CascoLogix/MSP430AFE253_Demo_Board/Hardware/MSP430AFE253_Pinout.xlsx

MSP430AFE253
Pin# | Pin Name | Alt Pin Name
1 | A0.0+
2 | A0.0-
3 | A1.0+
4 | A1.0-
5 | AVCC
6 | AVSS
7 | VREF
8 | A2.0+
9 | A2.0-
10 | TEST | SBWTCK
11 | ~RST | NMI/SBWTDIO
12 | P1.0 | SVSIN/TACLK/SMCLK/TA2
13 | DVSS
14 | P2.6 | XT2IN
15 | P2.7 | XT2OUT
16 | DVCC
17 | P1.1 | TA1/SDCLK
18 | P1.2 | TA0/SD0DO
19 | P1.3 | UTXD0/SD1DO
20 | P1.4 | URXD0/SD2DO
21 | P1.5 | SIMO0/SVSOUT/TMS
22 | P1.6 | SOMI0/TA2/TCK
23 | P1.7 | UCLK0/TA1/TDO/TDI
24 | P2.0 | STE0/TA0/TDI/TCLK
