CascoLogix/MSP430AFE253_Demo_Board/Rendered_Pics/MSP430AFE253_Demo_Board7.png

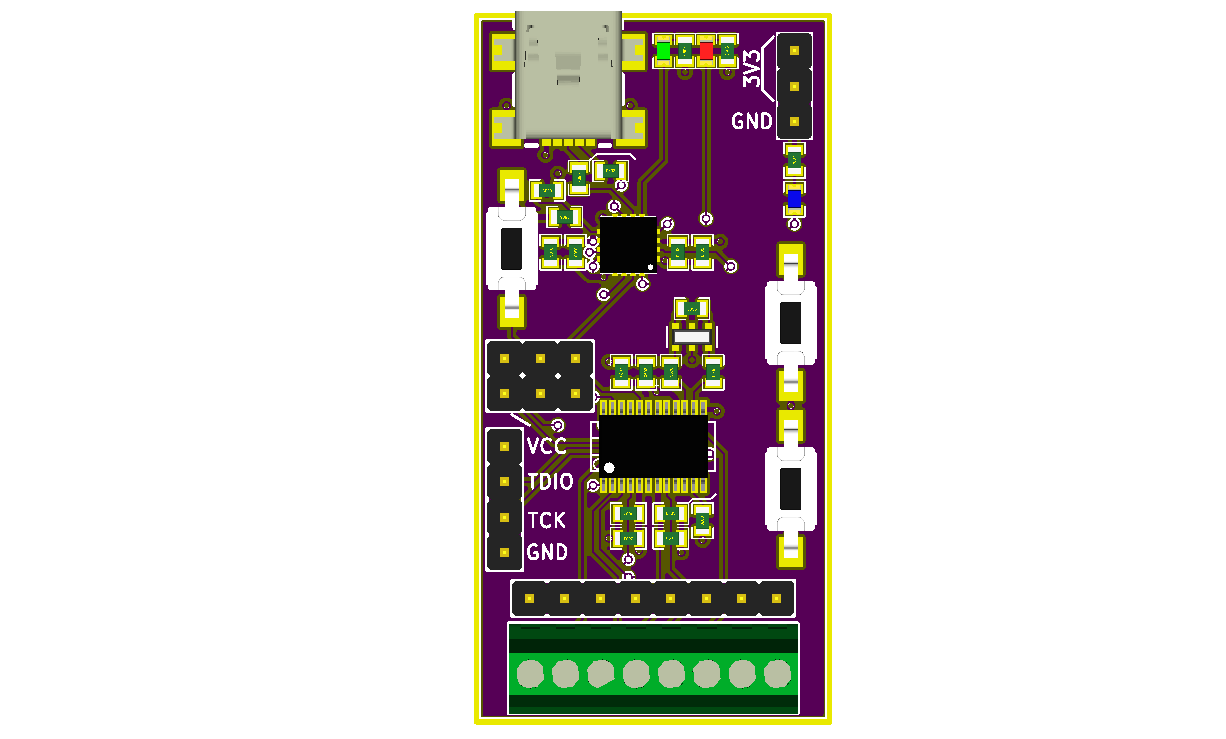
Rendered_Pics/MSP430AFE253_Demo_Board7.png
