CascoLogix/MSP430AFE253_Demo_Board/Rendered_Pics/MSP430AFE253_Demo_Board11.png

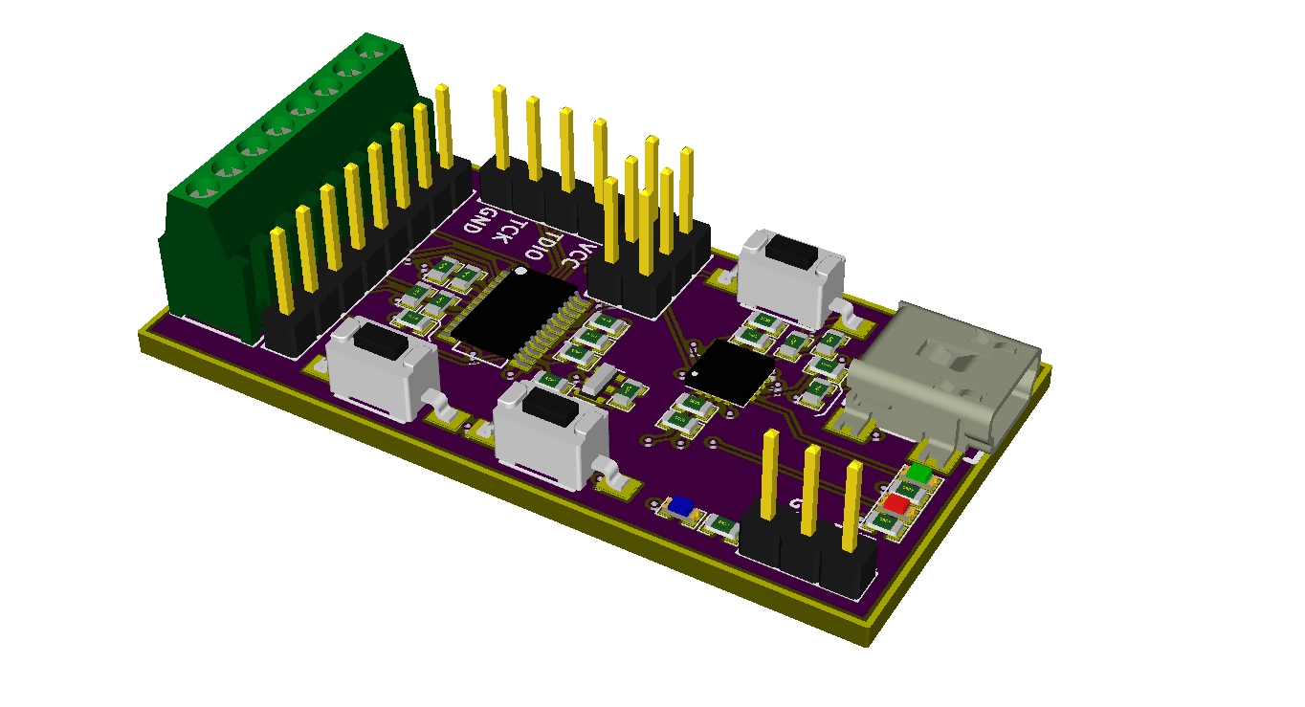
Rendered_Pics/MSP430AFE253_Demo_Board11.png
