CascoLogix/MSP430AFE253_Demo_Board/Rendered_Pics/MSP430AFE253_Demo_Board14.png

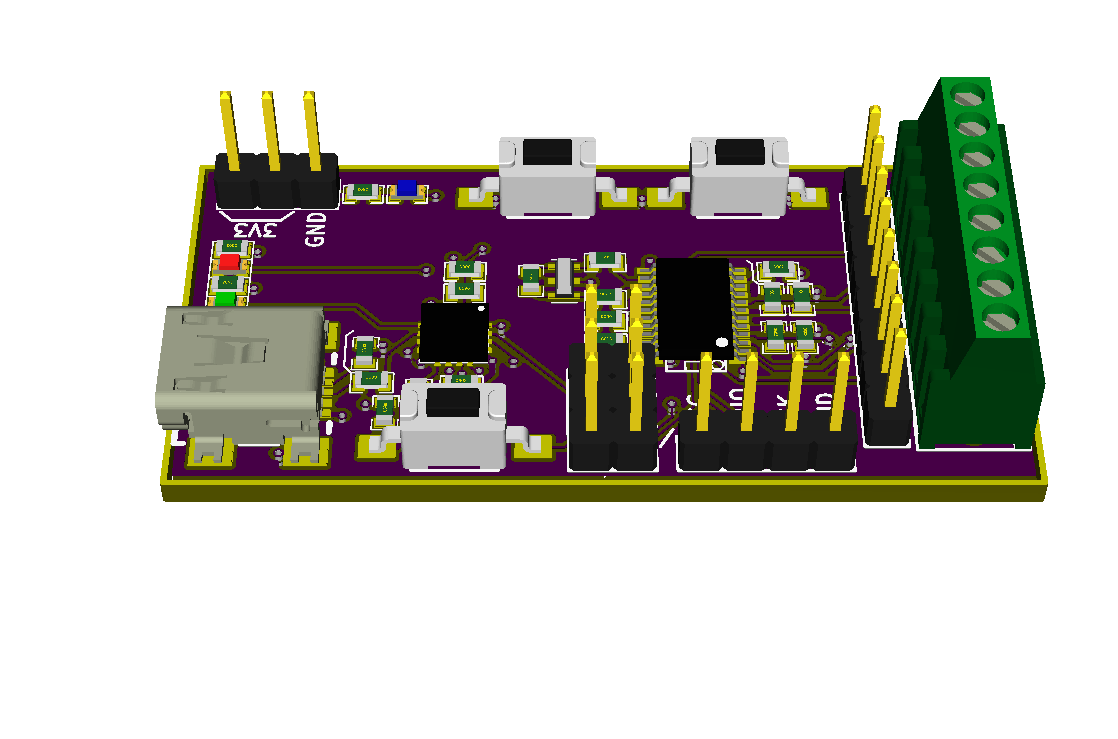
Rendered_Pics/MSP430AFE253_Demo_Board14.png
