CascoLogix/MSP430AFE253_Demo_Board/Rendered_Pics/MSP430AFE253_Demo_Board16.png

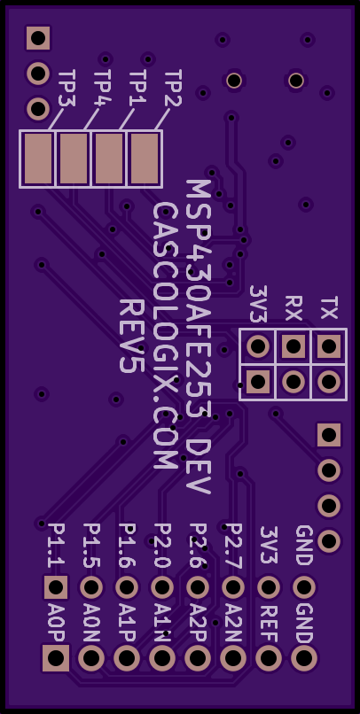
Rendered_Pics/MSP430AFE253_Demo_Board16.png
