CascoLogix/MSP430AFE253_Demo_Board/(list of files, cad)

Other CAD files:
Hardware/KiCAD_Project_Files/MSP430AFE253_Demo_Board.dxf
