CascoLogix/MSP430AFE253_Demo_Board/Hardware/Drawing/MSP430AFE253_Dev_Board_Schematic.pdf

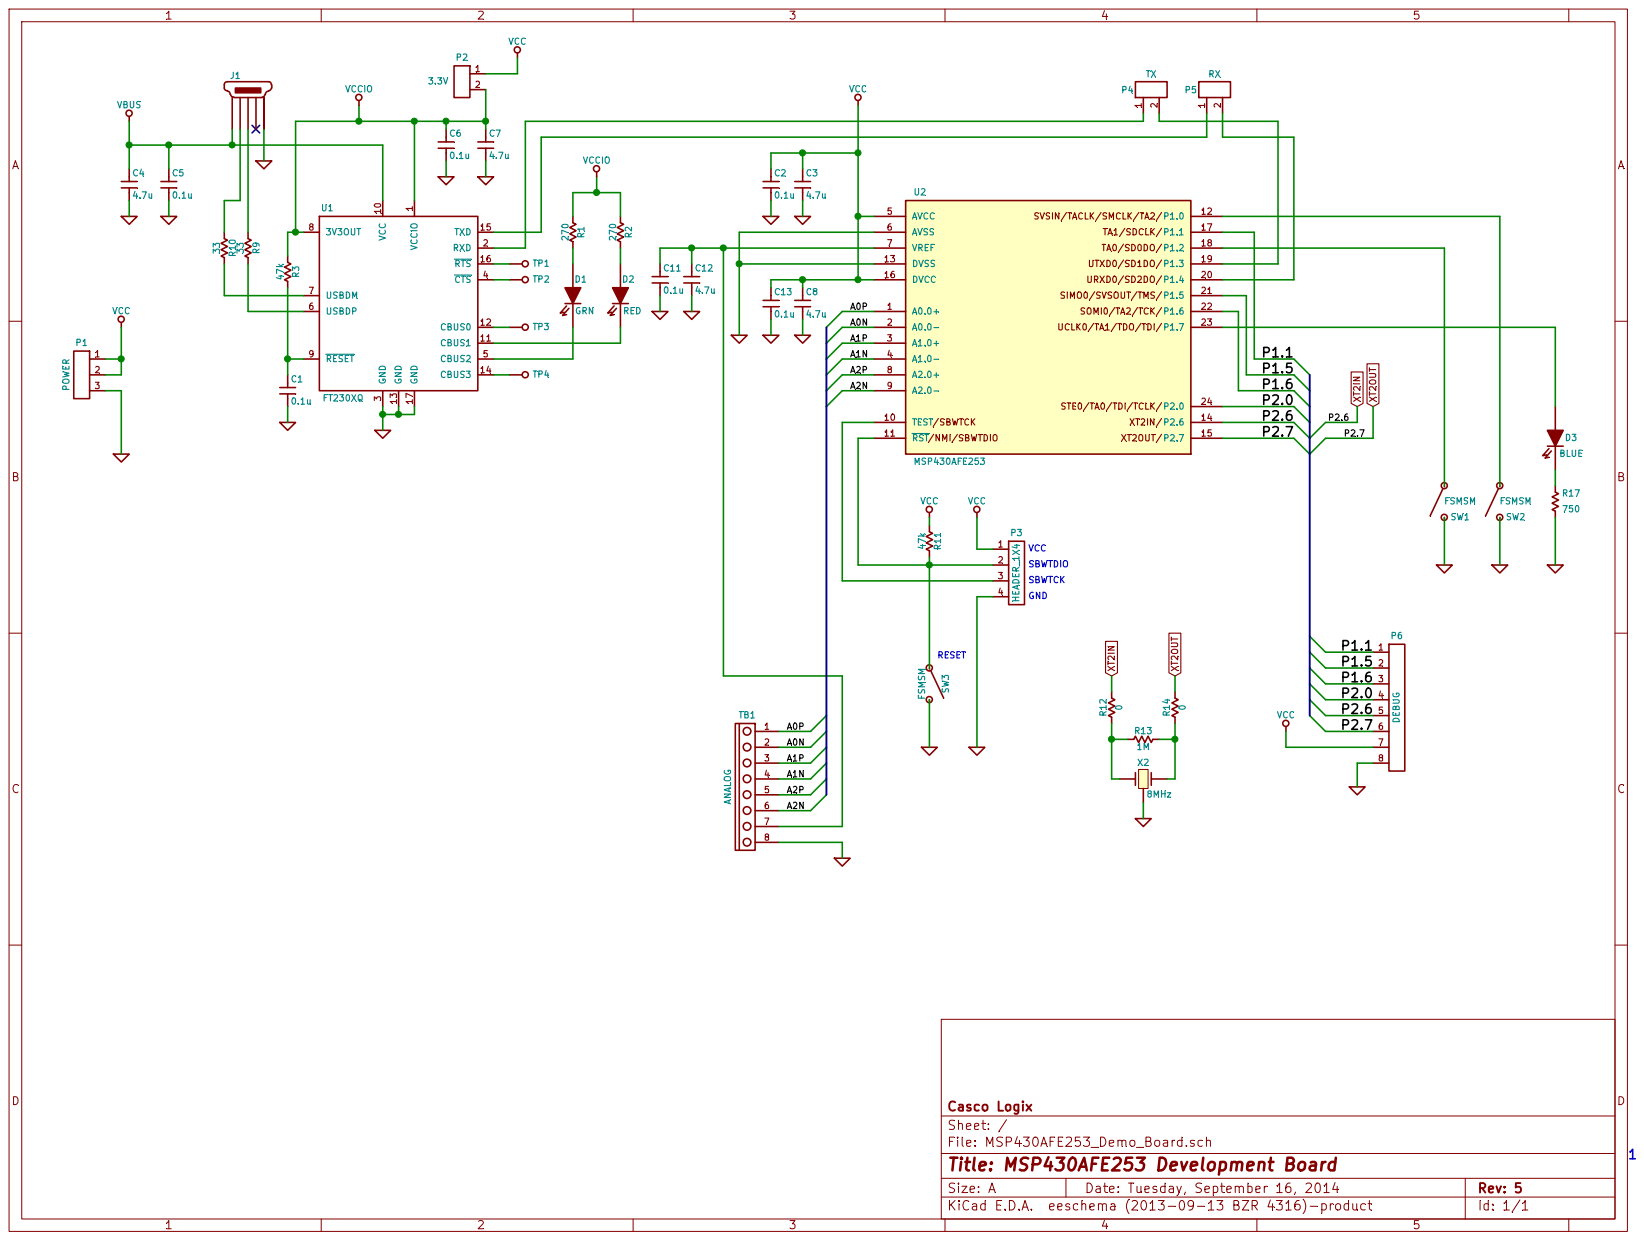
[picture p34: page 1]
