CascoLogix/MSP430AFE253_Demo_Board/Hardware/KiCAD_Project_Files/MSP430AFE253_Demo_Board.kicad_pcb

## KiCad design Hardware/KiCAD_Project_Files/MSP430AFE253_Demo_Board.kicad_pcb (2014-09-22)

Schematic: MSP430AFE253_Demo_Board.sch, MSP430AFE253 Development Board

Parts:
C1, C2, C5, C6, C11, C13: 0.1u
C3, C4, C7, C8, C12: 4.7u
D1: GRN
D2: RED
D3: BLUE
J1: USB_MINI_B
P1: POWER
P2: 3.3V
P3: HEADER_1X4
P4: TX
P5: RX
P6: DEBUG
R1, R2: 270
R3, R11: 47k
R9, R10: 33
R12, R14: 0
R13: 1M
R17: 750
SW1, SW2, SW3: FSMSM
TB1: ANALOG
TP1, TP2, TP3, TP4: 5015
U1: FT230XQ
U2: MSP430AFE253
X2: 8MHz

Connections:
+5V: C4.1, C5.1, J1.1, U1.10 (VCC)
/A0N: TB1.2, U2.2 (A0.0-)
/A0P: TB1.1, U2.1 (A0.0+)
/A1N: TB1.4, U2.4 (A1.0-)
/A1P: TB1.3, U2.3 (A1.0+)
/A2N: TB1.6, U2.9 (A2.0-)
/A2P: TB1.5, U2.8 (A2.0+)
/P1.1: P6.1, U2.17 (P1.1)
/P1.5: P6.2, U2.21 (P1.5)
/P1.6: P6.3, U2.22 (P1.6)
/P2.0: P6.4, U2.24 (P2.0)
GND: C1.2, C2.2, C3.2, C4.2, C5.2, C6.2, C7.2, C8.2, C11.2, C12.2, C13.2, J1.5, J1.6, J1.7, J1.8, J1.9, P1.3, P3.4, P6.8, R17.2, SW1.2, SW2.2, SW3.2, TB1.8, U1.3 (GND), U1.13 (GND), U1.17 (GND), U2.6 (AVSS), U2.13 (DVSS), X2.2
unnamed: R12.1, R13.1, X2.1
unnamed: R9.2, U1.6 (USBDP)
unnamed: R10.2, U1.7 (USBDM)
unnamed: SW2.1, U2.12 (P1.0)
unnamed: P5.2, U2.20 (P1.4)
unnamed: J1.2, R10.1
unnamed: TP4.1, U1.14 (CBUS3)
unnamed: C1.1, R3.2, U1.9 (~RESET)
unnamed: SW1.1, U2.18 (P1.2)
unnamed: TP1.1, U1.16 (~RTS)
unnamed: TP2.1, U1.4 (~CTS)
unnamed: TP3.1, U1.12 (CBUS0)
unnamed: R13.2, R14.1, X2.3
unnamed: D2.C, U1.11 (CBUS1)
unnamed: P4.1, U1.2 (RXD)
unnamed: P5.1, U1.15 (TXD)
unnamed: C11.1, C12.1, TB1.7, U2.7 (VREF)
unnamed: P3.3, U2.10 (TEST)
unnamed: D1.C, U1.5 (CBUS2)
unnamed: D2.A, R2.2
unnamed: D1.A, R1.2
unnamed: D3.C, R17.1
unnamed: P3.2, R11.2, SW3.1, U2.11 (~RST)
unnamed: P4.2, U2.19 (P1.3)
unnamed: J1.3, R9.1
unnamed: D3.A, U2.23 (P1.7)
VCC: C2.1, C3.1, C8.1, C13.1, P1.1, P1.2, P2.1, P3.1, P6.7, R11.1, U2.5 (AVCC), U2.16 (DVCC)
VCCIO: C6.1, C7.1, P2.2, R1.1, R2.1, R3.1, U1.1 (VCCIO), U1.8 (3V3OUT)
XT2IN: P6.5, R12.2, U2.14 (P2.6)
XT2OUT: P6.6, R14.2, U2.15 (P2.7)

Notes on the sheet:
GND
SBWTCK
SBWTDIO
VCC
RESET

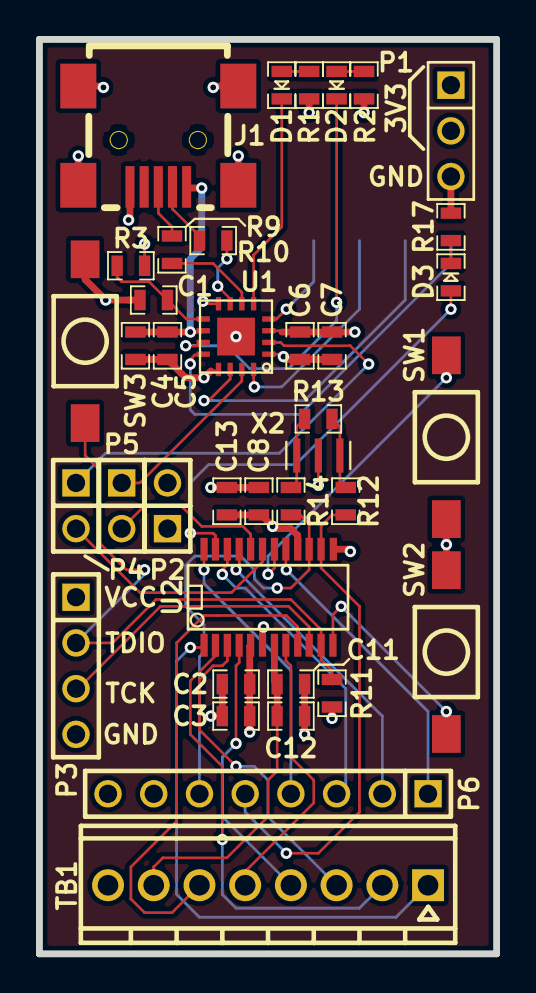
[picture p35: board MSP430AFE253_Demo_Board.kicad_pcb from above]

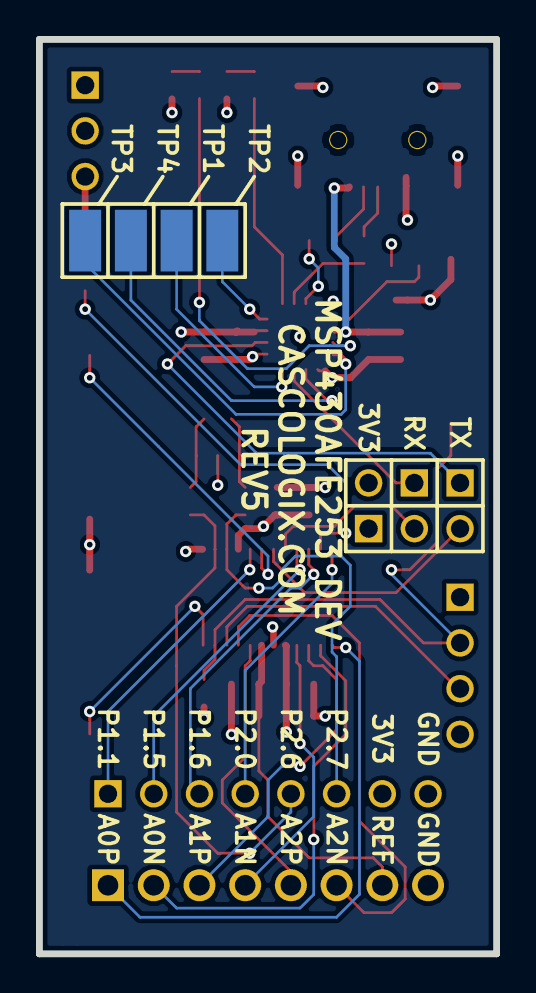
[picture p36: board MSP430AFE253_Demo_Board.kicad_pcb from below]

Board: 4 copper layers, 25.4 x 50.8 mm, 42 parts (4 on the bottom side), 42 nets.
