CascoLogix/MSP430AFE253_Demo_Board/(commit log)

2012-09-30 First KiCAD project commit
2012-09-30 Updated VCC track to go between header pins of RX & TX headers instead of around the outside near PCB edge. This allowed the GND plane (filled zone) to connect the GND pins of P3, P6, and TB1.
    [MSP430AFE253_Demo_Board.brd]
2012-09-30 Updated per VCC track change to route track through middle of RX & TX header pins instead of around outside near PCB edge.
    [MSP430AFE253_Demo_Board-Back.gbl, MSP430AFE253_Demo_Board-Front.gtl, MSP430AFE253_Demo_Board-Mask_Back.gbs, MSP430AFE253_Demo_Board-Mask_Front.gts, MSP430AFE253_Demo_Board-NPTH.drl, MSP430AFE253_Demo_Board-PCB_Edges.gbr, MSP430AFE253_Demo_Board-SilkS_Back.gbo, MSP430AFE253_Demo_Board-SilkS_Front.gto]
2012-11-06 First commmit after implementing standard project directory structure.
    [MSP430AFE253_Demo_Board-Post_Route.dsn, MSP430AFE253_Demo_Board-Pre_Route.dsn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]
2012-12-11 Rev'd board design and schematic to utilize smaller-footprint 8MHz crystal resonators.
    [MSP430AFE253_Demo_Board-Post_Route.dsn, MSP430AFE253_Demo_Board-Pre_Route.dsn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]
2013-01-12 Minor changes
    [MSP430AFE253_Demo_Board.brd]
2013-02-26 Corrected the Libraries directory in the project file to point to the correct file path Corrected the 3D model file paths in the board file to point to the correct 3D model directories
    [MSP430AFE253_Demo_Board.brd, MSP430AFE253_Demo_Board.sch]
2013-02-26 Updated PCB footprints to reference proper 3D LED components
    [MSP430AFE253_Demo_Board.brd]
2013-10-21 Updated to new kicad board format + Rendered pics
    [MSP430AFE253_Demo_Board.kicad_pcb]
2013-11-04 The Freescale USB-to-Serial IC seems to be obsolee. This is a baseline check-in before changing to the FTDI FT230XQ.
    [MSP430AFE253_Demo_Board.kicad_pcb, MSP430AFE253_Demo_Board.sch, MSP430AFE253_Demo_Board_BOM.xlsx]
2013-11-04 One file hadn't been saved prior to the previous check-in.
    [MSP430AFE253_Demo_Board.kicad_pcb]
2014-07-27 Rev 3 release
    [MSP430AFE253_Demo_Board-Post_Route.dsn, MSP430AFE253_Demo_Board-Pre_Route.dsn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]
2014-07-27 Clean up repo directory structure
    [MSP430AFE253_Demo_Board-Back.gbl, MSP430AFE253_Demo_Board-Front.gtl, MSP430AFE253_Demo_Board-Mask_Back.gbs, MSP430AFE253_Demo_Board-Mask_Front.gts, MSP430AFE253_Demo_Board-NPTH.drl, MSP430AFE253_Demo_Board-PCB_Edges.gbr, MSP430AFE253_Demo_Board-SilkS_Back.gbo, MSP430AFE253_Demo_Board-SilkS_Front.gto]
2014-07-27 Converted to git from hg
    [MSP430AFE253_Demo_Board.dxf, MSP430AFE253_Demo_Board.kicad_pcb, MSP430AFE253_Demo_Board.sch, MSP430AFE253_Pinout.xlsx]
2014-07-27 First commit as git repo
    [MSP430AFE253_Demo_Board.dxf, MSP430AFE253_Demo_Board.kicad_pcb, MSP430AFE253_Demo_Board.sch, MSP430AFE253_Pinout.xlsx]
2014-08-15 First commit at Rev 4
    [MSP430AFE253_Demo_Board.kicad_pcb, MSP430AFE253_Demo_Board.sch, SKU's.xlsx]
2014-08-15 Removed files inadvertently added in previous commit
    [SKU's.xlsx]
2014-08-15 Updated Schematic and Board design for corrected TX LED connection
    [MSP430AFE253_Demo_Board.kicad_pcb, MSP430AFE253_Demo_Board.sch]
2014-08-23 Check in current state of Rev 4 design (in-progress) before checking out and forking the Rev 1 design.
    [MSP430AFE253_Demo_Board.kicad_pcb, MSP430AFE253_Demo_Board.sch]
2014-08-23 Final commit for Rev4 release
    [MSP430AFE253_Demo_Board.dxf, MSP430AFE253_Demo_Board.kicad_pcb, MSP430AFE253_Demo_Board.sch, MSP430AFE253_Demo_Board_BOM.xlsx]
2014-08-23 Forgot to update rev info on back silkscreen
    [MSP430AFE253_Demo_Board.kicad_pcb, MSP430AFE253_Demo_Board.sch]
2014-08-27 Found quantity errors on BOM after last check in for Rev changes. Also added transparent background pics of 3D PCB assembly render.
    [MSP430AFE253_Demo_Board_BOM.xlsx]
2014-09-19 Rev 5 Commit. Generated new board gerbers and drawings. Updated user guide documentation and board renderings.
    [MSP430AFE253_Demo_Board.kicad_pcb, MSP430AFE253_Demo_Board.sch]
2014-09-22 Added datasheets.
    Updated PCB file to call out correct parts for 3D view.
    [MSP430AFE253_Demo_Board.kicad_pcb]
